LeaderXinjianSun/HB/Manual.md

# Welcome

## FOREWORD

Thank you for purchasing our products.
This manual contains the information necessary for the correct use of the Manipulator.
Please carefully read this manual and other related manuals before using our machine.
Keep this manual handy for easy access at all times.

## MANUFACTURER

**Jiang Su Leader Electronic Information Technology Co.,LTd **

**TEL**		:（86）0513-65060558

**FAX **	:（86）0512-65060559                 

## Table of Content##

[TOC]

## Safety

## Getting Started

## Operate

## SoftWare

## Appendix A: Q&A
