LeaderXinjianSun/HB/副本泰国HB改造物料单及IO.xlsx

Sheet: Sheet1
物料清单（电气）: |  |  |  |  | 编号：
项目名称： | 泰国HB改造项目 | 设计工程师： |  | 制 单 时 间：
客 户： |  | 领 料 人： |  | 装 配 时 间：
数 量： | 1 | 主 管 签 字： |  | 经 理 签 字：
CCD | BOM | 模块 | 型号 | 单位 | 品牌 | 单价 | 需求数量 | 备注
 |  | 笔型相机 | B011 | 台 | Supereyes |  | 1 | 已买
 |  | 500万黑白相机 CMOS | acA2500-14gm | 个 | BASLER |  | 2 | 已买
 |  | 镜头 | 2514H | 个 | VST |  | 2 | 已买
 |  | 光源+光源控制器 | 直径60mm | 套 | 沃德普 |  | 3 | 已买
电机 |  | 伺服电机 | FRLS10205A4C | 个 | 上银 |  | 4 | 换台达 | 脉冲*4 | 方向*4 | 伺服ON*4 | 极限*12
 |  | 伺服驱动器 | D2-0123-E-A0 | 个 | 上银 |  | 4 | 换台达
 |  | 电机动力线 | HVPS04AA03MB | 根 | 上银 |  | 4 | 换台达
 |  | 电机编码器线 | HVE13IAB03MB | 根 | 上银 |  | 4 | 换台达
 |  | 步进电机 | 57HS7630A4D8L | 个 | 三拓 |  | 1 | 已买
 |  | 步进驱动器 | 2M542 | 个 | 三拓 |  | 1 | 已买/2K电阻线焊好
传感器 |  | 旋转气缸磁性开关 | DMSH-020 | 个 | 亚德客 |  | 2
 |  | 无杆气缸磁感开关 | GL-8H | 个 | SUNX |  | 2
 |  | 光纤传感器（直径1.5） | FD-E13 | 根 | 松下 |  | 2
 |  | 光纤放大器 | FX-101 | 个 | 松下 |  | 2
 |  | 光纤传感器+放大器 | FU-35FA/FS-V21R | 套 | 基恩士 |  | 2
气动 |  | 负压表 | DP101 | 个 | 松下 |  | 8
 |  | 大电磁阀 | SY3120 | 个 | SMC |  | 12
 |  | 真空吸 |  |  |  |  |  | 尹宏飞负责
配件 |  | 大风扇（设备用） |  |  |  |  | 2 | 坏了更换
 |  | 白色线标号码管（光纤保护） |  |  |  |  | 10M

Sheet: Sheet2
FG上料X轴原点 | FG上料X轴脉冲 | 尹鸿飞
FG上料X轴正极限 | FG上料X轴方向 | 1 | 工件是否齐全（尤其是23号之前要改造的部分）
FG上料X轴反极限 | FG上料X轴伺服ON | 陈德师
FG上料X轴B工位感应光纤 | 条形码X轴脉冲 | 1 | 接线是怎么弄
FG上料AB工位切换感应1 | 条形码X轴方向 | 丁灵
FG上料AB工位切换感应2 | 条形码X轴伺服ON | 1 | 倍福怎么用
FG上料旋转气缸取料感应1 | 条形码Z轴脉冲 | 2 | 台达怎么用
FG上料旋转气缸到位感应2 | 条形码Z轴方向
条形码X轴原点 | 条形码Z轴伺服ON
条形码X轴正极限 | 条形码U轴脉冲
条形码X轴反极限 | 条形码U轴方向
条形码Z轴原点 | 条形码U轴伺服ON
条形码Z轴正极限 | 条形码滚筒脉冲
条形码Z轴反极限 | 条形码滚筒方向
条形码U轴原点 | FG上料旋转气缸
条形码取料真空吸负压表1 | FG上料AB工位切换气缸
条形码取料真空吸负压表2 | 条形码取料气缸1
条形码取料真空吸负压表3 | 条形码取料气缸2
条形码取料真空吸负压表4 | 条形码取料气缸3
条形码到位光纤感应1 | 条形码取料气缸4
条形码到位光纤感应2 | 撕膜平台真空吸3
 | 撕膜平台真空吸4
 | FPC上料分盘气缸
 | FPC下料分盘气缸
 | 成品TRAY盘上料分盘气缸
 | 成品TRAY盘下料分盘气缸

Sheet: Sheet3
IO表 |  |  |  |  | 轴定义
序号 | 输入输出 | PLC点位 | 名称 | 备注 | PLC
1 | I |  | FG上料X轴原点 |  | 轴1-11
2 | I |  | FG上料X轴正极限 |  | PLC
3 | I |  | FG上料X轴反极限 |  | 轴21 | FG上料X轴
4 | I |  | FG上料X轴B工位感应光纤 | *2 | 轴22 | 条码Y轴
5 | I |  |  | *2 | 轴23 | 滚压Z轴
6 | I |  | FG上料AB工位切换感应1 | 当前工位1 | 轴24 | 条码Z轴
7 | I |  | FG上料AB工位切换感应2 | 当前工位2 | 轴25 | 条码U轴
8 | I |  | 条形码Y轴原点 |  |  |  | EL2889
9 | I |  | 条形码Y轴正极限 |  |  |  | EL3054
10 | I |  | 条形码Y轴反极限
11 | I |  | 条形码Z轴原点
12 | I |  | 条形码Z轴正极限
13 | I |  | 条形码Z轴反极限
14 | I |  | 条形码U轴原点
1 | I |  | 条形码取料真空吸负压表1
2 | I |  | 条形码取料真空吸负压表2
3 | I |  | 条形码取料真空吸负压表3
4 | I |  | 条形码取料真空吸负压表4
5 | I |  | ng盘到位 |  | 台达PLC |  | 条形码到位光纤感应1
6 | I |  |  |  |  |  | 条形码到位光纤感应2
7 | I |  | 滚压Z轴原点
8 | I |  | 滚压Z轴正极限
9 | I |  | 滚压Z轴反极限
10 | I |  | 条码有料 | 从台达plc给出
11 | I |  | FG上料X轴A工位到位传感器（抽屉）
12 | I |  | FG上料X轴B工位到位传感器
1 | O |  | FG上料旋转气缸
2 | O |  | FG上料AB工位切换气缸
3 | O |  | 条形码取料气缸1
4 | O |  | 条形码取料气缸2
5 | O |  | 条形码取料气缸3
6 | O |  | 条形码取料气缸4
7 | O |  | 撕膜平台真空吸3
8 | O |  | 撕膜平台真空吸4
9 | O |  | FPC上料分盘气缸
10 | O |  | FPC下料分盘气缸
11 | O |  | 成品TRAY盘上料分盘气缸
12 | O |  | 成品TRAY盘下料分盘气缸
13 | O |  | 条形码取料真空吸1
14 | O |  | 条形码取料真空吸2
15 | O |  | 条形码取料真空吸3
16 | O |  | 条形码取料真空吸4
1 | O |  | 条形码取料破真空1
2 | O |  | 条形码取料破真空2
3 | O |  | 条形码取料破真空3
4 | O |  | 条形码取料破真空4
5 | O |  | 条码取完 | 给plc
6 | O |  | 贴码张开气缸

Sheet: 时序
时序 | 上位机→Barcode机构 | Barcode机构→上位机
 |  |  | Flag_CamAction_Remove
1 |  | Flag_Barcode_Need_Cam
2 | Flag_Barcode_Need_Cam_Finsh
3 | Flag_Barcode_Can_Fit
4 |  | Flag_Barcode_Fit_Finish
时序 | Barcode机构 | 上位机 | 右滑台 | 滚压机构
1 |  |  | Process_4_Can_Push
2 |  |  |  | Process_3_Set_Finish
3 |  |  | Flag_RightStage_Cam_Pos1_Ready
4 |  | Flag_RightStage_Cam_Pos1_Finish
5 |  |  | Flag_RightStage_Cam_Pos2_Ready
6 |  | Flag_RightStage_Cam_Pos2_Finish
 |  |  | Flag_CamAction_Remove
 | Flag_Barcode_Need_Cam
7 |  |  | Flag_RightStage_RemoveLiner_Ready
8 |  | Flag_RightStage_Robot_RemoveLiner_Ready
9 |  |  | Flag_RightStage_RemoveLinered_Ready
10 |  | Flag_RightStage_Robot_RemoveLinered_Ready
11 |  |  | Flag_Barcode_Can_Fit
12 | Flag_Barcode_Fit_Finish
13 |  |  | Flag_RightStage_Cam_Brd1_Ready
14 |  | Flag_RightStage_Cam_Brd1_Finish
15 |  |  | Flag_RightStage_Cam_Brd2_Ready
16 |  | Flag_RightStage_Cam_Brd2_Finish
17 |  |  | Flag_RightStage_Cam_Brd3_Ready
18 |  | Flag_RightStage_Cam_Brd3_Finish
19 |  |  | Flag_RightStage_Cam_Brd4_Ready
20 |  | Flag_RightStage_Cam_Brd4_Finish
21 |  |  | Flag_RightStage_WaitCatch_Ready
22 |  | Flag_RightStage_WaitCatch_Finish
23
24
25
26
27
28

Sheet: 倍福IO表
序号 | 端子 | 输入 | 信号 | 模块 | 端子 | 输出 | 信号 | 模块
1 | Input1 | X0_1 | 送料上升正极限【轴3】 | EL1889_1 | Output1 | Y0_1 | 右滑台真空吸1 | EL2889_1
2 | Input2 | X0_2 | 送料上升原点【轴3】 |  | Output2 | Y0_2 | 滑台真空吸2
3 | Input3 | X0_3 | 送料上升反极限【轴3】 |  | Output3 | Y0_3 | 撕膜位置真空吸
4 | Input4 | X0_4 | 送料移栽正极限【轴4】 |  | Output4 | Y0_4 | 矫正电机撕膜夹子左右气缸
5 | Input5 | X0_5 | 送料移栽原点【轴4】 |  | Output5 | Y0_5 | 滑台真空吸1
6 | Input6 | X0_6 | 送料移栽反极限【轴4】 |  | Output6 | Y0_6 | 左升降平移气缸
7 | Input7 | X0_7 | 送料撕膜正极限【轴5】 |  | Output7 | Y0_7 | 左升降上下气缸
8 | Input8 | X0_8 | 送料撕膜原点【轴5】 |  | Output8 | Y0_8 | 左升降真空吸
9 | Input9 | X0_9 | 送料撕膜反极限【轴5】 |  | Output9 | Y0_9
10 | Input10 | X0_10 | 左送料上升正极限【轴6】 |  | Output10 | Y0_10 | 滚压推入气缸
11 | Input11 | X0_11 | 左送料上升原点【轴6】 |  | Output11 | Y0_11 | 滚压下压压板气缸
12 | Input12 | X0_12 | 左送料上升反极限【轴6】 |  | Output12 | Y0_12 | 滚压平台真空吸
13 | Input13 | X0_13 | 左收盘下降正极限【轴7】 |  | Output13 | Y0_13 | 滚压翻转气缸
14 | Input14 | X0_14 | 左收盘下降原点【轴7】 |  | Output14 | Y0_14 | 右滑台真空吸4
15 | Input15 | X0_15 | 左收盘下降反极限【轴7】 |  | Output15 | Y0_15
16 | Input16 | X0_16 |  |  | Output16 | Y0_16 | 右升降平移气缸
17 | Input1 | X1_1 |  | EL1889_2 | Output1 | Y1_1 | 右升降上下气缸 | EL2889_2
18 | Input2 | X1_2 |  |  | Output2 | Y1_2 | 右升降真空吸
19 | Input3 | X1_3 | 右送盘上升正极限【轴8】 |  | Output3 | Y1_3 | FG上料AB工位切换气缸
20 | Input4 | X1_4 | 右送盘上升原点【轴8】 |  | Output4 | Y1_4 | 矫正电机撕膜夹子上下气缸
21 | Input5 | X1_5 | 右送盘上升反极限【轴8】 |  | Output5 | Y1_5 | 安全门信号-输出到继电器-给机械手
22 | Input6 | X1_6 | 右收料下降正极限【轴9】 |  | Output6 | Y1_6 | 追加上顶气缸1
23 | Input7 | X1_7 | 右收料下降原点【轴9】 |  | Output7 | Y1_7 | 追加上顶气缸2
24 | Input8 | X1_8 | 右收料下降反极限【轴9】 |  | Output8 | Y1_8
25 | Input9 | X1_9 |  |  | Output9 | Y1_9 | FPC扣紧气缸
26 | Input10 | X1_10 |  |  | Output10 | Y1_10 | 初始吹膜1
27 | Input11 | X1_11 |  |  | Output11 | Y1_11 | 吹膜2
28 | Input12 | X1_12 | 滚压正极限【轴10】 |  | Output12 | Y1_12
29 | Input13 | X1_13 | 滚压原点【轴10】 |  | Output13 | Y1_13 | 绿灯
30 | Input14 | X1_14 | 滚压反极限【轴10】 |  | Output14 | Y1_14 | 黄灯
31 | Input15 | X1_15 | FPC上升到位传感器 |  | Output15 | Y1_15 | 红灯
32 | Input16 | X1_16 | FPC下降抽屉到位传感器 |  | Output16 | Y1_16 | 蜂鸣器
33 | Input1 | X2_1 | FG上料X轴B工位感应光纤 | EL1889_3
34 | Input2 | X2_2 | 左送料上升到位光纤
35 | Input3 | X2_3 | 左收盘上升到位光纤
36 | Input4 | X2_4 | 右送料上升到位光纤
37 | Input5 | X2_5 | 右收盘上升到位光纤
38 | Input6 | X2_6
39 | Input7 | X2_7 | 撕膜电机吸产品负压表1
40 | Input8 | X2_8 | 撕膜电机吸产品负压表2
41 | Input9 | X2_9 | TRAY盘抽屉上升到位传感器【轴8】
42 | Input10 | X2_10 | 左升降平移气缸SET
43 | Input11 | X2_11 | 左升降平移气缸RST
44 | Input12 | X2_12 | 左升降上下气缸SET
45 | Input13 | X2_13 | 左升降上下气缸RST
46 | Input14 | X2_14 | 左升降真空负压表
47 | Input15 | X2_15 | TRAY盘抽屉下降到位传感器【轴8】
48 | Input16 | X2_16 | 滚压推进气缸SET
49 | Input1 | X3_1 | 滚压推进气缸RST | EL1889_4
50 | Input2 | X3_2
51 | Input3 | X3_3
52 | Input4 | X3_4 | 滚压翻转气缸SET
53 | Input5 | X3_5 | 滚压翻转气缸RST
54 | Input6 | X3_6 | 滚压平台真空吸负压表
55 | Input7 | X3_7
56 | Input8 | X3_8 | 右升降平移气缸SET
57 | Input9 | X3_9 | 右升降平移气缸RST
58 | Input10 | X3_10 | 右升降上下气缸SET
59 | Input11 | X3_11 | 右升降上下气缸RST
60 | Input12 | X3_12 | 右升降真空负压表
61 | Input13 | X3_13 | PASS TRAY上料门感应
62 | Input14 | X3_14 | 前门左门感应
63 | Input15 | X3_15 | 前门右门感应
64 | Input16 | X3_16 | 后门左门感应
65 | Input1 | X4_1 | 后门右门感应 | EL1889_5
66 | Input2 | X4_2 | HB上料门感应1
67 | Input3 | X4_3 | HB上料门感应2
68 | Input4 | X4_4 | 启动按钮
69 | Input5 | X4_5 | 停止按钮
70 | Input6 | X4_6 | 复位按钮
71 | Input7 | X4_7 | 急停按钮
72 | Input8 | X4_8 | 轴11正转极限【轴11】
73 | Input9 | X4_9 | 轴11原点【轴11】
74 | Input10 | X4_10 | 轴11反转极限【轴11】
75 | Input11 | X4_11 | 左移栽上顶气缸SET1
76 | Input12 | X4_12 | 左移栽上顶气缸RST1
77 | Input13 | X4_13 | 左移栽上顶气缸SET2
78 | Input14 | X4_14 | 左移栽上顶气缸RST2
79 | Input15 | X4_15
80 | Input16 | X4_16
81 | Input1 | X100_1 | FG上料X轴原点【21轴】 | EL1889_6 | Output1 | Y100_1 | FG上料旋转气缸 | EL2889_3
82 | Input2 | X100_2 | FG上料X轴正极限【21轴】 |  | Output2 | Y100_2
83 | Input3 | X100_3 | FG上料X轴反极限【21轴】 |  | Output3 | Y100_3 | 条形码取料气缸1
84 | Input4 | X100_4 | FG上料X轴B工位感应光纤 |  | Output4 | Y100_4 | 条形码取料气缸2
85 | Input5 | X100_5 |  |  | Output5 | Y100_5 | 条形码取料气缸3
86 | Input6 | X100_6 | FG上料AB工位切换感应1 |  | Output6 | Y100_6 | 条形码取料气缸4
87 | Input7 | X100_7 | FG上料AB工位切换感应2SET |  | Output7 | Y100_7 | 右滑台真空吸2
88 | Input8 | X100_8 | 条形码Y轴原点【22轴】 |  | Output8 | Y100_8 | 右滑台真空吸3
89 | Input9 | X100_9 | 条形码Y轴正极限【22轴】 |  | Output9 | Y100_9 | FPC上料分盘气缸
90 | Input10 | X100_10 | 条形码Y轴反极限【22轴】 |  | Output10 | Y100_10 | FPC下料分盘气缸
91 | Input11 | X100_11 | 条形码Z轴原点【轴24】 |  | Output11 | Y100_11 | 成品TRAY盘上料分盘气缸
92 | Input12 | X100_12 | 条形码Z轴正极限【轴24】 |  | Output12 | Y100_12 | 成品TRAY盘下料分盘气缸
93 | Input13 | X100_13 | 条形码Z轴反极限【轴24】 |  | Output13 | Y100_13 | 条形码取料真空吸1
94 | Input14 | X100_14 | 条形码U轴原点【轴25】 |  | Output14 | Y100_14 | 条形码取料真空吸2
95 | Input15 | X100_15 |  |  | Output15 | Y100_15 | 条形码取料真空吸3
96 | Input16 | X100_16 |  |  | Output16 | Y100_16 | 条形码取料真空吸4
97 | Input1 | X101_1 | 条形码取料真空吸负压表1 | EL1889_7 | Output1 | Y101_1 | 条形码取料破真空1 | EL2889_4
98 | Input2 | X101_2 | 条形码取料真空吸负压表2 |  | Output2 | Y101_2 | 条形码取料破真空2
99 | Input3 | X101_3 | 条形码取料真空吸负压表3 |  | Output3 | Y101_3 | 条形码取料破真空3
100 | Input4 | X101_4 | 条形码取料真空吸负压表4 |  | Output4 | Y101_4 | 条形码取料破真空4
101 | Input5 | X101_5 | ng盘到位 |  | Output5 | Y101_5 | 条码取完【给plc】
102 | Input6 | X101_6 |  |  | Output6 | Y101_6 | 贴码张开气缸
103 | Input7 | X101_7 | 滚压Z轴原点【23轴】 |  | Output7 | Y101_7
104 | Input8 | X101_8 | 滚压Z轴正极限【23轴】 |  | Output8 | Y101_8
105 | Input9 | X101_9 | 滚压Z轴反极限【23轴】 |  | Output9 | Y101_9
106 | Input10 | X101_10 | 条码有料【从台达plc给出】 |  | Output10 | Y101_10
107 | Input11 | X101_11 | FG上料X轴A工位到位传感器（抽屉） |  | Output11 | Y101_11
108 | Input12 | X101_12 | FG上料X轴B工位到位传感器 |  | Output12 | Y101_12
109 | Input13 | X101_13 |  |  | Output13 | Y101_13
110 | Input14 | X101_14 |  |  | Output14 | Y101_14
111 | Input15 | X101_15 |  |  | Output15 | Y101_15
112 | Input16 | X101_16 |  |  | Output16 | Y101_16

Sheet: Sheet5
-95.766 | -101.534 | -5.768 | -5.768
334.972 | 329.204
393.94 | 388.172
453.47 | 447.702
513 | 507.232
36.629
47.488 |  | 10.859
23.124 | 60.238
83.362 | 59.542
142.904 | 59.632
202.536
 |  |  |  | 9.73
96.19 | 4
0 | 5

Sheet: Sheet4
334.972
393.626
453.918
513.302
 |  |  | 178.33
 | 20.568
 | 199.588 | 179.02

Sheet: TRAY逻辑
 |  |  |  | 动作1 | 动作2 | 动作3
FPC上升盘 | Liftin_Feed_Left_1 | 急停后 | （不间断上料，料盘会掉） | 下降到底 | FPC紧扣气缸置位，分盘气缸复位，开始往上升，光纤感应到，停
 |  | 上位机下降命令 | （不间断上料，料盘会掉） | 下降到底 | FPC紧扣气缸置位，分盘气缸复位，开始往上升，光纤感应到，停
 |  | 超过上限位（坐标） |  | 分盘气缸置位，下降到底 | FPC紧扣气缸置位，分盘气缸复位，开始往上升，光纤感应到，停
 |  | 料盘空命令 |  | FPC紧扣气缸复位 | 料盘被取走，上升，光纤感应到，停
FPC下降盘 | Liftin_Feed_Left_2 | 急停后 | （不间断上料，料盘会掉） | 下降到底 | 分盘气缸复位，开始往上升，光纤感应到，停 | 再往下走，光纤信号无，停
 |  | 上位机下降命令 | （要求上升时，托盘上无料盘） | 下降到底 | 分盘气缸复位，开始往上升，到上位置（坐标），停。
 |  | 超过下限位（坐标） | （要求上升时，托盘上无料盘） | 分盘气缸置位，下降到底 | 分盘气缸复位，开始往上升，到上位置（坐标），停。
 |  | 料盘空命令 |  | 料盘放好，下降升，光纤信号无，停
 |  |  |  | 动作1 | 动作2 | 动作3
产品上升盘 | Liftin_Feed_Right_Up | 急停后 | （不间断上料，料盘会掉） | 下降到底 | 分盘气缸复位，开始往上升，光纤感应到，停
 |  | 上位机下降命令 | （不间断上料，料盘会掉） | 下降到底 | 分盘气缸复位，开始往上升，光纤感应到，停
 |  | 超过上限位（坐标） |  | 分盘气缸置位，下降到底 | 分盘气缸复位，开始往上升，光纤感应到，停
 |  | 料盘空命令 |  |  | 料盘被取走，上升，光纤感应到，停
产品上升盘 | Liftin_Feed_Right_Down | 急停后 | （不间断上料，料盘会掉） | 下降到底 | 分盘气缸复位，开始往上升，光纤感应到，停 | 再往下走，光纤信号无，停
 |  | 上位机下降命令 | （要求上升时，托盘上无料盘） | 分盘气缸置位，下降到底，给出RDY要求上料 | 分盘气缸复位，开始往上升，到上位置（坐标），停。
 |  | 超过下限位（坐标） | （要求上升时，托盘上无料盘） | 分盘气缸置位，下降到底，给出RDY要求上料 | 分盘气缸复位，开始往上升，到上位置（坐标），停。
 |  | 料盘空命令 |  | 料盘放好，下降升，光纤信号无，停
