LeaderXinjianSun/HB/io表等/HB项目物料单.xlsx

 |  |  |  |  |  |  |  |  |  | 文件编号： | LDR-SJ-007
物料清单（电气）: |  |  |  |  |  |  |  |  |  | 编号：
项目名称： |  | HB泰国项目 |  |  | 设计工程师： |  |  |  | 制 单 时 间：
客 户： |  | 泰国藤仓 |  |  | 领 料 人： |  |  |  | 装 配 时 间：
数 量： |  | 1套 |  |  | 主 管 签 字： |  |  |  | 经 理 签 字：
序号 | 物料编号 | 物料名称 |  | 型号 |  | 品牌 | 数量 | 单位 | 单价 | 采购件 | 链接
 |  | PLC | 倍福耦合器 | EK1100 |  | 倍福 | 1 | 片
 |  |  | 倍福输入模块 | EL1889 |  | 倍福 | 6 | 片
 |  |  | 倍福输出模块 | EL2889 |  | 倍福 | 6 | 片
 |  |  | 台达PLC | DVPSS |  | 台达 | 1 | 台
 |  |  | 网线 | 5m |  |  | 8 | 根 |  | 是
 |  |  | 网线 | 2m |  |  | 6 | 根 |  | 是 | https://item.taobao.com/item.htm?spm=a230r.1.14.164.SZa0tn&id=18744826546&ns=1&abbucket=4#detail
 |  |  | 网线 | 0.3m |  |  | 12 | 根 |  | 是 | https://detail.tmall.com/item.htm?id=532631583386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 | 超五类橙色
 |  | 机械手 | 机械手 | LS3-401S |  | Epson | 3 | 套
 |  | 电机与 驱动器 | EtherCat驱动器+电机 | 100W(带刹车) |  | 上银 | 1 | 套
 |  |  | EtherCat驱动器+电机 | 100W |  | 上银 | 3 | 套
 |  |  | EtherCat驱动器+电机 | 400W(带刹车) |  | 上银 | 4 | 套
 |  |  | EtherCat驱动器+电机 | 400W |  | 上银 | 2 | 套
 |  |  | 电机动力线 | 5m |  | 上银 | 9 | 根
 |  |  | 电机编码器线 | 5m |  | 上银 | 9 | 根
 |  |  | 电机编码器线 | 5m |  | 上银 | 9 | 根
 |  |  | 歩进电机驱动器 | MB450A |  | 三拓 | 1 | 个 |  | 是
 |  |  | 57步进电机 |  |  | 三拓 | 1 | 个
 |  | 电脑 | 戴尔主机 | D08S |  | 戴尔 | 1 | 台
 |  |  | PCI-E网卡 |  |  |  | 1 | 个
 |  |  | 显示器 | 戴尔17寸 |  |  | 2 | 台 |  | 是
 |  |  | 鼠标键盘 | 罗技MK120 |  |  | 1 | 套 |  | 是
 |  |  | 交换机 | TP-LINK |  |  | 1 | 台
 |  |  | USB相机(扫码用) | 网件 |  |  | 1 | 套 |  | 是 | https://item.taobao.com/item.htm?id=520042527276&ali_trackid=1_7ef330281e8cbcbca112b6cc905f3f4d
 |  |  | VGA线 | 3m |  |  | 2 | 根 |  | 是 | https://detail.tmall.com/item.htm?id=525145338242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
 |  | 面板 | 启动按钮【常开】 | XB5-AA313C 绿色 |  | 施耐德 | 1 | 个
 |  |  | 停止按钮【常闭】 | XB5-AA42C 红色 |  | 施耐德 | 1 | 个
 |  |  | 复位按钮【常开】 | XB5-AA51C 黄色 |  | 施耐德 | 1 | 个
 |  |  | 旋钮开关 | XB5AD21C |  | 施耐德 | 1 | 个
 |  |  | 急停按钮 | XB2-BS642C 1常闭 |  | 施耐德 | 4 | 个
 |  |  | 三色灯 | XVG-B3SM |  | 施耐德 | 1 | 个
 |  |  | 风扇 | DLF1224LB(12cm) |  |  | 10 | 个
 |  |  | 防爆灯 | 亮度可调 |  |  | 1 | 个
 |  | 传感器 | 负压表 | DP-100 |  | 松下 | 5 | 个
 |  |  | 门感应 | FM18-08N |  |  | 5 | 个
 |  |  | 光纤传感器+放大器 | FU-35FA/FS-V21R |  | 基恩士 | 7 | 个
 |  |  | 模组光电开关 | 上银配 |  |  | 27 | 个
 |  |  | 日本真空发生器 | ZK2A07K5KW-06 |  | SMC | 7 | 个
 |  |  | 压力传感器显示 | 四位单显 |  |  | 1 | 个 |  | 是 | https://item.taobao.com/item.htm?spm=2013.1.0.0.waqmdZ&id=13508986989
 |  |  | 压力传感器 | 0-20kg |  |  | 1 | 个 |  | 是 | https://item.taobao.com/item.htm?spm=a1z10.5-c.w4002-14800924410.32.uonFGX&id=26029992587
 |  | 开关 电源 | 开关电源 | NDR-240-24 240W |  | 铭伟 | 1 | 个
 |  |  |  |  |  |  |  | 个
 |  |  |  |  |  |  |  | 个
 |  | 主电路开关 | 旋钮总开关 | VCF1C KCF1PZC+V1C 32A |  | 施耐德 |  |  |  | 是 | https://item.taobao.com/item.htm?spm=a230r.1.14.39.lYavpI&id=541055575012&ns=1&abbucket=7#detail
 |  |  | 主控漏电保护开关 | DZ47LE-32-2P-32A |  | 施耐德 | 2 | 个
 |  |  | 空气开关 | DZ47-2P 16A |  | 德力西 | 1 | 个
 |  |  | 空气开关 | DZ47-2P 10A |  | 德力西 | 2 | 个
 |  |  | 空气开关 | DZ47-2P 20A |  | 德力西 | 1 | 个 |  | 是
 |  |  | 空气开关 | DZ47-2P 2A |  | 德力西 | 1 | 个
 |  |  | 防爆插头/插座 | 插头和插座32A |  | 德力西 | 1 | 套 |  | 是 | https://detail.tmall.com/item.htm?id=538252670190&cm_id=140105335569ed55e27b&abbucket=7&skuId=3215407573636
 |  |  | 电源指示灯 | XB2-BVM1LC |  | 施耐德 | 1 | 个
 |  | 配件 | 继电器 | MY2N-GS D24V |  | 欧姆龙 | 2 | 个
 |  |  | 拖线板 | 公牛10插 3m |  | 公牛 | 2 | 个 |  | 是
 |  |  | 转接板 | ST081N |  |  | 6 | 个 |  | 是
 |  |  | 捷固端子 |  |  |  | 若干 | 个
 |  |  | DB50端子台 | 孔座 |  |  | 3 | 个 |  | 是
 |  |  | DB50连接线 | 公对母2米 |  |  | 3 | 个 |  | 是
 |  |  | DB25连接线 | 公对母2米 |  |  | 3 | 个 |  | 是
 |  |  | 线槽 |  |  |  | 若干 | 个
 |  |  | 导轨 |  |  |  | 若干 | 个
 |  |  | 多芯线 |  |  |  | 若干 | 米
 |  |  | 三芯电源线 |  |  |  | 若干 | 米
 |  |  | 电源线（黄色） | 1.5平方 |  | 远东 | 若干 | 米
 |  |  | 电源线（蓝色） | 1.5平方 |  | 远东 | 若干 | 米
 |  |  | PE线（黄绿） | 1.5平方 |  | 远东 | 若干 | 米
 |  |  | 信号线（红） | 0.75平方 |  | 远东 | 若干 | 米
 |  |  | 信号线（黑） | 0.75平方 |  | 远东 | 若干 | 米
 |  |  | 贴纸 |  |  |  | 1 | 个 |  | 是 | 设计定制
 |  |  | 标签 |  |  |  | 1 | 个 |  | 是 | 设计定制
