LeaderXinjianSun/HB/(list of files, cad)

Other CAD files:
HB.dwg
