LeaderXinjianSun/HB/(commit log)

2017-05-13 回原点完成
    [副本泰国HB改造物料单及IO.xlsx]
2017-05-14 滚压完成；上料待分工位程序修改；台达程序设计完成
    [副本泰国HB改造物料单及IO.xlsx]
2017-05-15 barcode debug ready
    [副本泰国HB改造物料单及IO.xlsx]
2017-05-16 添加新加轴的调试界面
    [副本泰国HB改造物料单及IO.xlsx]
2017-05-18 整机运行1次
    [副本泰国HB改造物料单及IO.xlsx]
